suburns05/EGR314SamBurns.github.io/docs/index.md

---
title: Welcome
tags:
- tag1
- tag2
---
<center>
<font size= "6">Sam Burns Datasheet</font><br>
as part of<br>
<font size= "8"> ROV MINI SUB</font><br>
for<br>
<font size= "5"> Team 308 </font><br>

**Submission: May, 4, 2026**
</center>

## Introduction

* This is a project formed out of the reqirements listed in EGR 314 Spring 2026. The tast was to make a reaserch/exploratory vessal to help collect data of a given envitement. We decided to underwater, although this prototype does not go underwater the sensors are dirrected to basic underwater data collection. 

### Project Summary

* We are a team designing a underwater reaserch drone. My main conponet was a wireless controller that serves as a way for the user to see the sensor values from the sub but also to navigate the sub. 
* Team link [team report.](https://egr314-s-2026-308.github.io/)

### My Contribution

* This subsystems is the Teams HMI system. 
* This site serves as documentation of the steps taken to reach the final product of this subsystem.
