suburns05/EGR314SamBurns.github.io/docs/11-Version 2.0/Version 2.0.md

---
title: Version 2.0
---

## Future Possible Updates

If I had a 2nd attempt at this with all I know now, I have a list of changes/improvments I would like to try: 

- Adding abuilt in battery system that was designed to intergrate with the PCB.
- Adding futher menu navigation.
- Improving menu navigation to be more user friednly.
- Implementing mini animations to make the UI feel more active. 
- Increasing the pre-programed measages I can send and request.
- I would like to have spent more time on the case, making it feel more polished and look like a final product. 
- In the future I would also pick larger surface mount parts, although small parts look good the larger they are the easier to solder they are.
- Definetly would want to improve the general power management for the whole project. 
- Looking futher into why one of the directions on one of the joysticks was not working and regaining that functionality back would have been nice.
