suburns05/EGR314SamBurns.github.io/docs/Appendix/index.md

---
title: Appendix - Main Page
---

## Appendix Content

* [Component Selection Process](https://embedded-systems-design.github.io/EGR314DataSheetTemplate/Appendix/01-Componet-Selection/Component-Selection-Process/)
* [Microcontroller Selection Process (to Pic)](https://embedded-systems-design.github.io/EGR314DataSheetTemplate/Appendix/02-Microcontroller-Selection/pic-table/)
* [Power Budget](https://embedded-systems-design.github.io/EGR314DataSheetTemplate/Appendix/03-Power-Budget/Power-Budget/)
<!-- * [Example 01 (Need to remove/hide before review!)](https://embedded-systems-design.github.io/EGR314DataSheetTemplate/Appendix/04-Examples-to-Remove/basic-markdown-examples/)
* [Example 02 (Need to remove/hide before review!)](https://embedded-systems-design.github.io/EGR314DataSheetTemplate/Appendix/04-Examples-to-Remove/charts/) -->

3D model for final product [here](base.STL).
