suburns05/EGR314SamBurns.github.io/docs/12-Resources/Resources.md

---
title: Resources
---

## Links/Files of final product

3D model for final product [here](base.STL). 

The software zip folder for this project can be found [*here*](HMI_SUBSYSTEM.zip)

## Final Look 

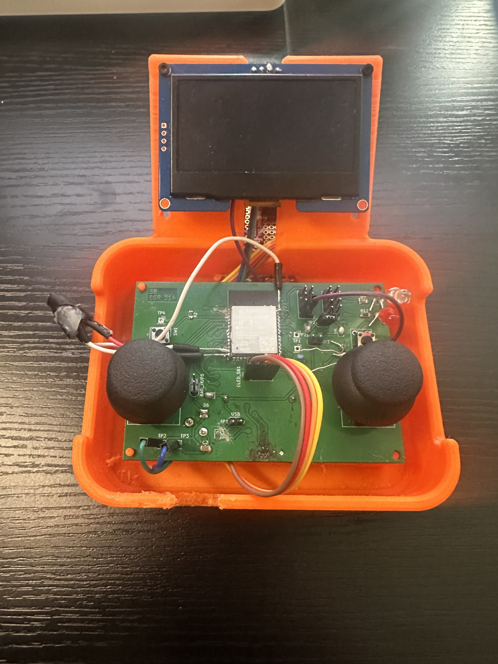
[picture p5: docs/12-Resources/top.jpg]
build

**Figure ##:** Top view of completed project.

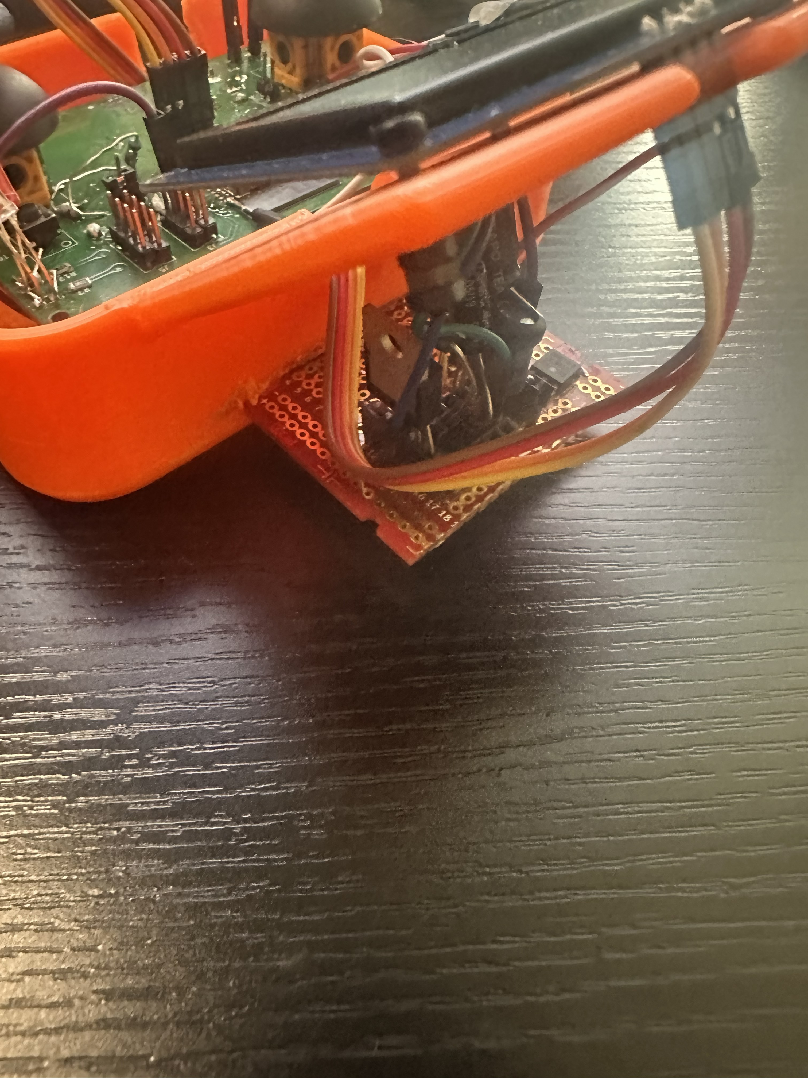
[picture p6: docs/12-Resources/regulator.jpg]
power_supply

**Figure ##:** the external power regulator to help stabalize power.

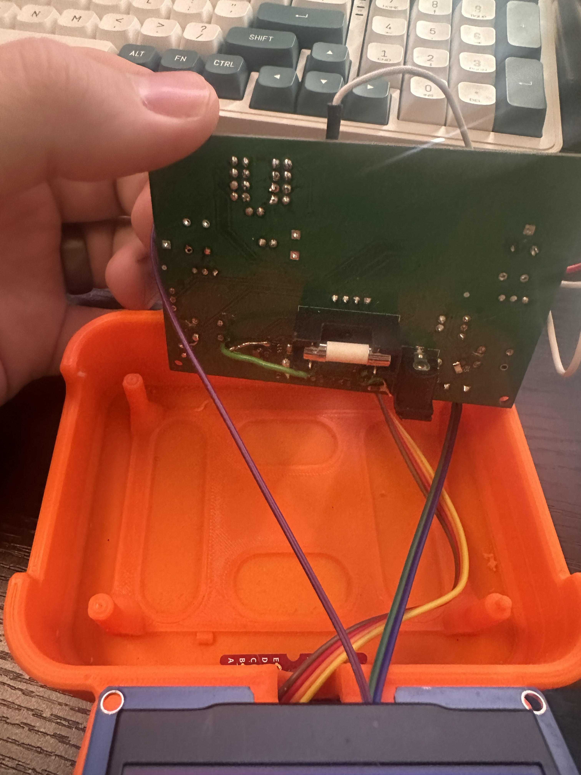
[picture p7: docs/12-Resources/bottom.jpg]
bottom

**Figure ##:** Bottom view of completed project.
