suburns05/EGR314SamBurns.github.io/docs/08-PCB/DFM.pdf

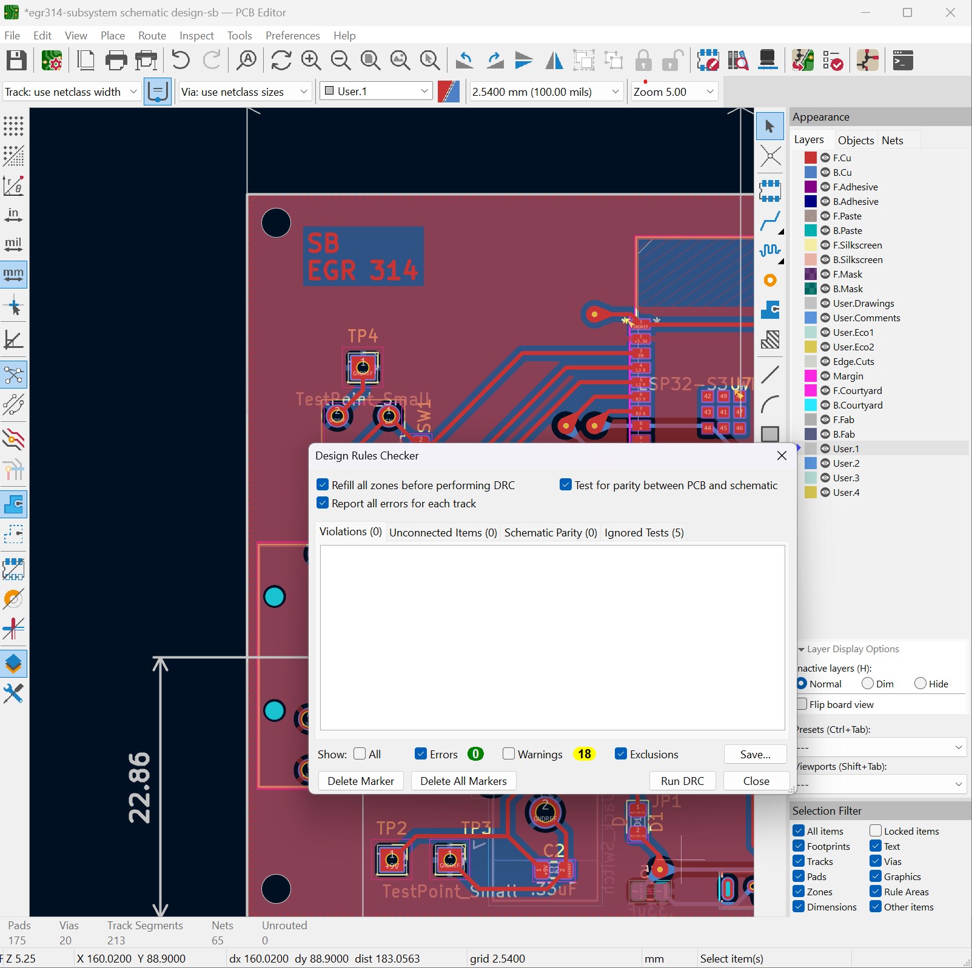
[picture p8: page 1]
