suburns05/EGR314SamBurns.github.io/docs/03-Component-Selection/Component-Selection.md

---
title: Module's Selected Major Components
---

## Module's Selected Major Components

The following are the selected major components necessary for my subsystem of our proejct. This system is the Human Machine Interface, which acts similar to a typical RC remote with additional information and customization that can be done on the fly. 

### Power Management

I will proceed with option 3 due to being the most affordable option I found. I also believe that this option will be the easiest to work with.

### Joystick

I will proceed with #2 due to how simple and inexpensive the product is. It was allowed dispait the combonet being a through hole set up, this part allows for better controll overall. 

### OLED

I choose option 3 due to being largest screen. This will help a lot to show real time data coming back from our submarine.

-----------

### Component selection 

**Joystick**

| **Component** | **Pros** | **Cons** |
| --- | --- | --- |
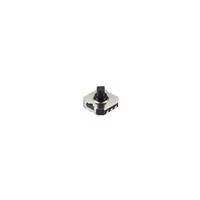
[picture p9: docs/03-Component-Selection/joystick1.png]
| <br> #1 SKRHAAE010 surface mount Joystick<br>$2.98/each<br>[link to product](https://www.digikey.com/en/products/detail/alps-alpine/SKRHAAE010/19529098) | \* Inexpensive <br>\* Low profile <br>\* Meets surface mount constraint of project <br>\* No possible way for to get stick drift | \* Limited output range compared to an analog joystick <br> \* Needs additional parts to be user friendly |
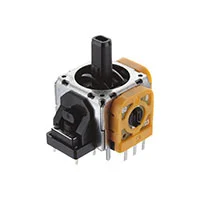
[picture p10: docs/03-Component-Selection/joystick2.png]
| <br> #2 THB001P Through hole mount Joystick<br>$3.04/each<br>[link to product](https://www.digikey.com/en/products/detail/c-k/THB001P/11687191) | \* Typical Joystick configuration <br>\* Highrange of outputs<br>\* Enables persision control | \* Doesn't meet surface mount constraint of project<br>\* Possiblity of stickdrift |
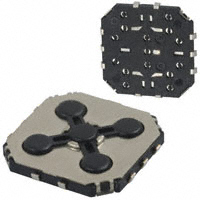
[picture p11: docs/03-Component-Selection/joystick3.png]
| <br> #3 JS1300AQ surface mount D-Pad<br>$2.18/each<br>[link to product](https://www.digikey.com/en/products/detail/e-switch/JS1300AQ/1556576) | \* Larger input area <br>\* Easier to use<br>\* Cheaper compared to other selected options | \*Limited outputs <br>\* Large footprint compared to other selected options | 

**Screen**

| **Component** | **Pros** | **Cons** |
| --- | --- | --- |
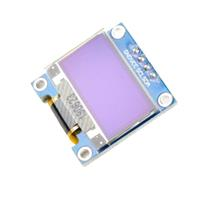
[picture p12: docs/03-Component-Selection/oled1.png]
| <br> #1 26095 Through hole OLED <br>$4.99/each<br>[link to product](https://www.digikey.com/en/products/detail/universal-solder-electronics-ltd/26095/16822116) | \* Familiar with due to Lab <br>\* Low profile <br>\*Popular option with a lot of open source help | \* Small screen <br> \* Doesn't meet Surface mount constraints of project |
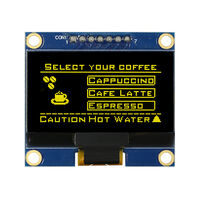
[picture p13: docs/03-Component-Selection/oled2.png]
| <br> #2 WEA012864ALAP3N00E00 Through hole OLED <br>$14.78/each<br>[link to product](https://www.digikey.com/en/products/detail/winstar-display/WEA012864ALAP3N00E00/24883012) | \* Larger screen <br>\* Yellow text | \* Unfamilar pin set up <br> \*Very expensive <br> \* Doesn't meet Surface mount constraints of project |
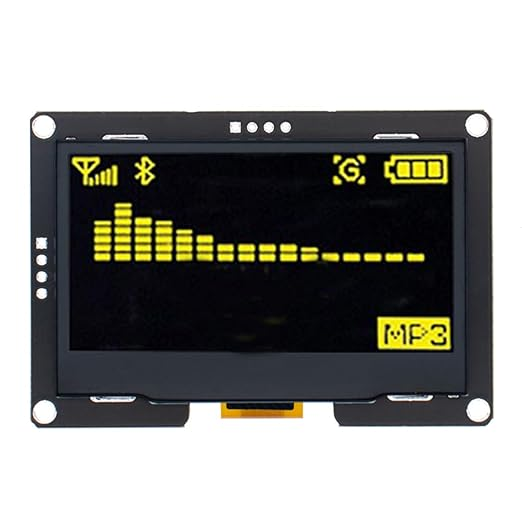
[picture p14: docs/03-Component-Selection/oled3.png]
| <br> #3 B0CFF2TSJ1 Through hole OLED <br>$16.99/each<br>[link to product](https://www.digikey.com/en/products/detail/winstar-display/WEA012864ALAP3N00E00/24883012) | \* Largest screen out of my selection <br>\* Same address as one provided in class, just larger pixels | \* Seems to only be sold on Amazon <br> \*Very expensive <br> \* Doesn't meet Surface mount constraints of project |

**Voltage regulator**

| **Component** | **Pros** | **Cons** |
| --- | --- | --- |
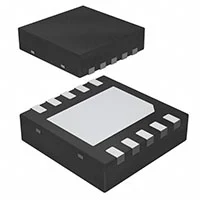
[picture p15: docs/03-Component-Selection/reg1.png]
| <br> #1 LP3996SD-0833/NOPB Dual output Voltage regulator <br>$1.12/each<br>[link to product](https://www.digikey.com/en/products/detail/texas-instruments/LP3996SD-0833-NOPB/1590116) | \* Small foot print <br>\* dual output <br>\*Will short if over powered | \*Limited Input voltage <br> \* Possibly over complicated for project |
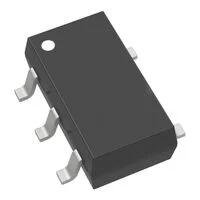
[picture p16: docs/03-Component-Selection/reg2.png]
| <br> #2 MIC5365-3.3YC5-TR Voltage regulator <br>$0.12/each<br>[link to product](https://www.digikey.com/en/products/detail/microchip-technology/MIC5365-3-3YC5-TR/1868094) | \* Simple desing <br>\* Very inexpensive | \* Low input Voltage <br> \* Limited Output current |
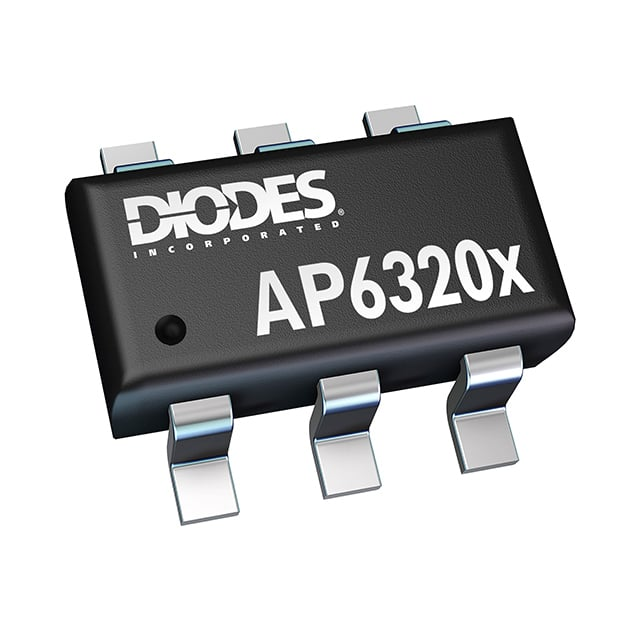
[picture p17: docs/03-Component-Selection/reg3.png]
| <br> #3 AP63203WU-7 Voltage regulator <br>$0.16/each<br>[link to product](https://www.digikey.com/en/products/detail/diodes-incorporated/AP63203WU-7/9858426) | \* Highest input Voltage out of my selection <br>\* Higher output current | \* No over voltage protection built in <br> \*Long manufacturing time  |

<!-- ### Style 2

> Also acceptable, more markdown friendly

**External Clock Module**

1. XC1259TR-ND surface mount crystal

    ![](image1.png)

    * $1/each
    * [link to product](http://www.digikey.com/product-detail/en/ECS-40.3-S-5PX-TR/XC1259TR-ND/827366)

    | Pros                                      | Cons                                                             |
    | ----------------------------------------- | ---------------------------------------------------------------- |
    | Inexpensive                               | Requires external components and support circuitry for interface |
    | Compatible with PSoC                      | Needs special PCB layout.                                        |
    | Meets surface mount constraint of project |

**Rationale:** A clock oscillator is easier ... -->

## Final Notes

I didn't really change any of the major componets. However I either read the datasheet wrong or our regulator was simply not good. Half of our team had breakout board powersupplies due to this simple error that is apparent on all of our boards. For future refference I would pick a requlator that had a larger headroom and also a larger footprint. I think my issue was I some how limited my outgoing current, I got 3.3 v however it would boot cycle if I program it. The OLED and Joysticks were great, 100% recommend using them again.
