suburns05/EGR314SamBurns.github.io/docs/07-BOM/BOM.md

---
title: Module Bill of Materials
tags:
- tag1
- tag2
---

## Overview
Here is a rough over view of my BOM. Very simple break down of my componets that are directly sourced through KiCad. Other then the previously listed major componets there are a lot of ressistor, capacitors and diodes that bring the project to life.

## Bill of Materials 
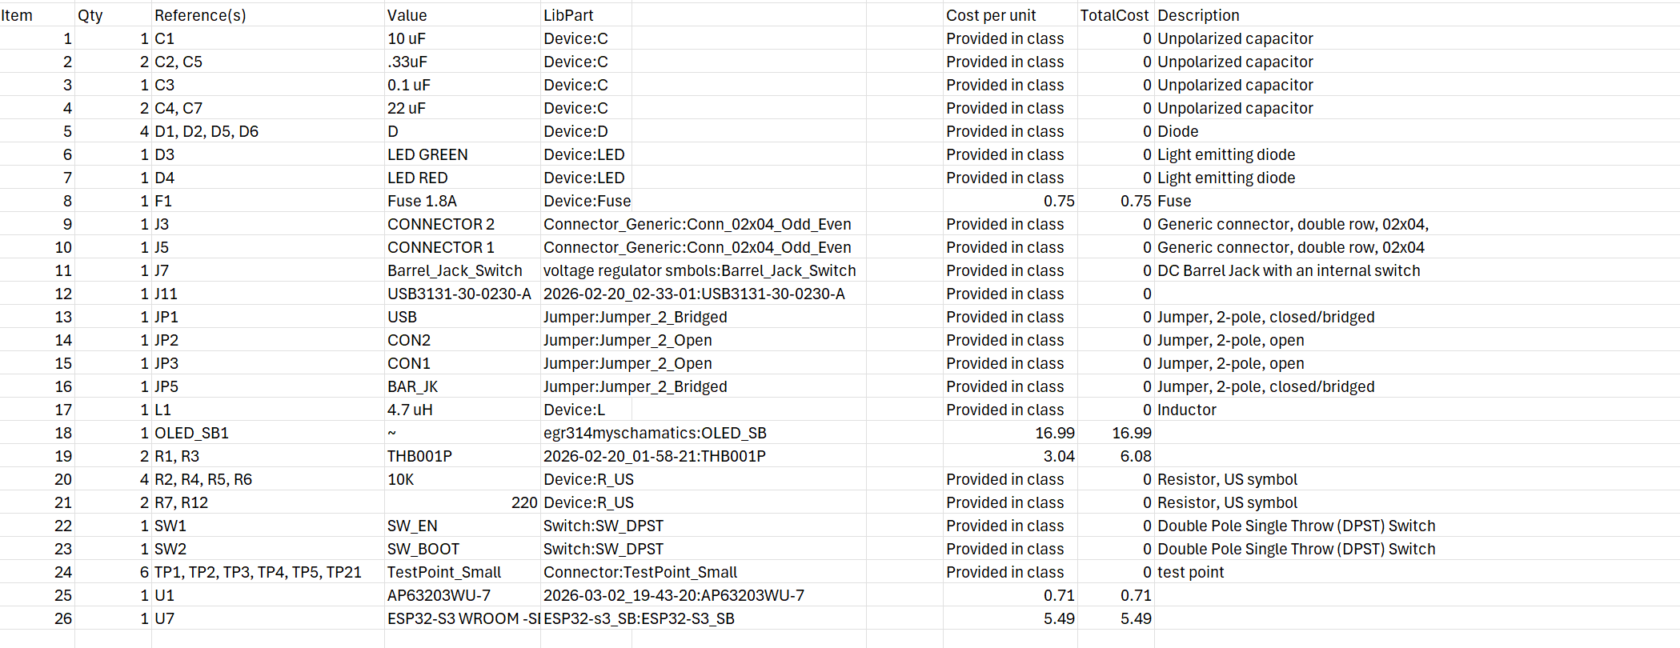
[picture p18: docs/07-BOM/image.png]


As you can see, the text can be difficult to read without opening the image.

## Resouce

The Bill of Material as a PDF download is available [*here*](EGR_314.pdf), and Excel File [here](egr314_BOM.xlsx). See my order request file [fere](EGR-314-Purchase-Request-2026-DIGI-KEY.xlsx) 

## Final Notes

Next time get 2-3x what you would need. If you have the buget, use it. Do not make the same mistake I did. I assumed that the lab/shop would have some of my parts, however if everyone thinks that, it is very likely that those supplies go out quick. I had to make parts that were way to big to my design and make it work. Its good practice to get good at soldering surface mount parts. Howeve I would avoid the headache and get what you need and then some.
