suburns05/EGR314SamBurns.github.io/docs/07-BOM/EGR314_BOM.pdf

Source: C:\Users\umutb\OneDrive - Arizona State University\SPRING 26\egr 314(kicad)\egr314-subsystem schematic design-sb\egr314-subsystem schematic design-sb.kicad_sch
Date: | 2026-03-05T20:36:01-0700
Tool: | Eeschema 9.0.4
Generator: C:\Program Files\KiCad\9.0\bin\scripting\plugins/bom_csv_grouped_by_value.py
Component Count:41

Collated Components:

Item | Qty | Reference(s) | Value | LibPart
1 | 1 C1 | 10 uF | Device:C
2 | 2 C2, C5 | .33uF | Device:C
3 | 1 C3 | 0.1 uF | Device:C
4 | 2 C4, C7 | 22 uF | Device:C
5 | 4 D1, D2, D5, D6 | D | Device:D
6 | 1 D3 | LED GREEN | Device:LED
7 | 1 D4 | LED RED | Device:LED
8 | 1 F1 | Fuse 1.8A | Device:Fuse
9 | 1 J3 | CONNECTOR 2 | Connector_Generic:Conn_02x04_Odd_Even
10 | 1 J5 | CONNECTOR 1 | Connector_Generic:Conn_02x04_Odd_Even
11 | 1 J7 | Barrel_Jack_Switch voltage regulator smbols:Barrel_Jack_Switch
12 | 1 J11 | USB3131-30-0230-A 2026-02-20_02-33-01:USB3131-30-0230-A
13 | 1 JP1 | USB | Jumper:Jumper_2_Bridged
14 | 1 JP2 | CON2 | Jumper:Jumper_2_Open
15 | 1 JP3 | CON1 | Jumper:Jumper_2_Open
16 | 1 JP5 | BAR_JK | Jumper:Jumper_2_Bridged
17 | 1 L1 | 4.7 uH | Device:L
18 | 1 OLED_SB1 | ~ | egr314myschamatics:OLED_SB
19 | 2 R1, R3 | THB001P | 2026-02-20_01-58-21:THB001P
20 | 4 R2, R4, R5, R6 | 10K | Device:R_US
21 | 2 R7, R12 | 220 Device:R_US
22 | 1 SW1 | SW_EN | Switch:SW_DPST
23 | 1 SW2 | SW_BOOT | Switch:SW_DPST
24 | 6 TP1, TP2, TP3, TP4, TP5, TP21 | TestPoint_Small | Connector:TestPoint_Small
25 | 1 U1 | AP63203WU-7 | 2026-03-02_19-43-20:AP63203WU-7
26 | 1 U7 | ESP32-S3 WROOM -SBESP32-s3_SB:ESP32-S3_SB

| Cost per unit | TotalCost
| Provided in class | 0
| Provided in class | 0
| Provided in class | 0
| Provided in class | 0
| Provided in class | 0
| Provided in class | 0
| Provided in class | 0
0.75 0.75
Connector_Generic:Conn_02x04_Odd_Even | Provided in class | 0
Connector_Generic:Conn_02x04_Odd_Even | Provided in class | 0
voltage regulator smbols:Barrel_Jack_Switch | Provided in class | 0
2026-02-20_02-33-01:USB3131-30-0230-A | Provided in class | 0
| Provided in class | 0
| Provided in class | 0
| Provided in class | 0
| Provided in class | 0
| Provided in class | 0
16.99 16.99
3.04 6.08
| Provided in class | 0
| Provided in class | 0
| Provided in class | 0
| Provided in class | 0
| Provided in class | 0
0.71 0.71
5.49 5.49

Description
Unpolarized capacitor
Unpolarized capacitor
Unpolarized capacitor
Unpolarized capacitor
Diode
Light emitting diode
Light emitting diode
Fuse
Generic connector, double row, 02x04, Generic connector, double row, 02x04 DC Barrel Jack with an internal switch

Jumper, 2-pole, closed/bridged Jumper, 2-pole, open
Jumper, 2-pole, open
Jumper, 2-pole, closed/bridged Inductor

Resistor, US symbol
Resistor, US symbol
Double Pole Single Throw (DPST) Switch Double Pole Single Throw (DPST) Switch test point
