suburns05/EGR314SamBurns.github.io/docs/07-BOM/EGR-314-Purchase-Request-2026-DIGI-KEY.xlsx

Sheet: Purchase Request
Course/Capstone/eProject/FURI Purchase Request
Name of Class or Project: EGR 304/314 |  |  |  | Vendor (one vendor per form): Digi-key
Date | Faculty/PI Contact | Student Name & Email | eProject? Capstone Project? Course Project? |  |  | eProject Industry Sponsor (if applicable)
2026-03-05 | Nichols | Sam Burns suburns@asu.edu | Yes / No Yes / No Yes / No |  |  | n/a
A purchasing card is available to check out for local purchases or you may come to Sutton 101 and order your supplies, using this purchasing card.
Qty | Item # or Quote # | Direct Website Link to Product |  | General Description of Item |  | Business Purpose/Benefit for the Purchase | Unit Price | Line Total
6 | 12345ABCDE | www.thisistheplace.com/12345ABCDE (SAMPLE: PLEASE START ON NEXT LINE) |  | safety goggles |  | protect student/instructor eyes while working on project; benefit to the University of reducing number of accidents in the lab | $3.490 | $20.94
4 | THB001P | https://www.digikey.com/en/products/detail/c-k/THB001P/11687191 |  | JOYSTICK |  | allows for control and navigation of controller | $3.04 | $12.16
2 | AP63203WU-7 | https://www.digikey.com/en/products/detail/diodes-incorporated/ap63203wu-7/9858426 |  | 3.3 V 2A converter |  | Converts input Volts to 3.3V | $0.710 | $1.42
3 | ESP32-S3-WROOM-1-N8 | https://www.digikey.com/en/products/detail/espressif-systems/ESP32-S3-WROOM-1-N8/15200089 |  |  |  | Micro chip that runs the prooject | 5.49 | $16.47
1 | 4628 | https://www.digikey.com/en/products/detail/keystone-electronics/4628/2137316 |  | Fuse holder |  | Holds the replaceble fuse | $0.750 | $0.75
 |  |  |  |  |  |  |  | $0.00
 |  |  |  |  |  |  |  | $0.00
 |  |  |  |  |  |  |  | $0.00
 |  |  |  |  |  |  |  | $0.00
 |  |  |  |  |  |  |  | $0.00
 |  |  |  |  |  |  |  | $0.00
 |  |  |  |  |  |  |  | $0.00
 |  |  |  |  |  |  |  | $0.00
 |  |  |  |  |  |  |  | $0.00
 |  |  |  |  |  |  |  | $0.00
 |  |  |  |  |  |  | Sub-Total | $30.80
Chair or PI Approval: |  |  |  |  | Date: |  | Tax
 |  |  |  |  |  |  | Shipping
 |  |  |  |  |  |  | Grand Total | $30.80
Business Purpose/Public Benefit: (Click on yellow line. Next, select an option on the drop-down arrow on the right of the box)
Lab / Classroom / Medical Supplies
Business Purpose: A commodity needed for experimentation, observation or practice in a field of study (such as goggles, aprons, test tubes, flasks, and plates etc).
Public Benefit: Supplies are used in day-to-day lab operations. ASU benefits from this expense as the supplies purchased allow departmental lab employees and students to perform general lab duties, projects, and research activities.
Student: Forward completed form to Instructor/Project Mentor for approval
Mentor/Faculty: Forward form with email indicating your approval to PolyBizz@asu.edu for processing
 | 1. A purchasing card is available to check out for local purchases. 2. You may come to Sutton 101 and place your order online.
SECTION BELOW IS FOR OFFICE USE ONLY
ORDER PLACED BY / DATE: |  |  |  |  |  | B.O. NOTIFIED BY / DATE:
ORDER RECEIVED BY / DATE: |  |  |  |  |  | STUDENT / INSTRUCTOR NOTIFIED BY / DATE:
COST CENTER + PROGRAM/GIFT TO CHARGE:

Sheet: Sheet1
Category |  |  | Reimbursement Justification
Audiovisual Electronic Equipment and Accessories (Non-Capital) | Business Purpose: Non-capital Audiovisual devices, equipment, or accessories purchased to facilitate The Polytechnic School business and operations. | Public Benefit: ASU benefits from this expense as the items purchased allow faculty, staff, and students to conduct video conferencing and/or meetings and discussions with a technological aide to further Polytechnic School business, operations, and maintain partnerships and collaboration with off-campus organizations. | Purchase Made Outside Business Hours | The items or services purchased were made outside of business hours, most often for immediate use outside of business hours. It was necessary for the Requestor to make this purchase, as the need for it was imperative.
Audiovisual R/M Supplies | Business Purpose: Audiovisual commodity items purchased to maintain Audiovisual equipment. | Public Benefit: ASU benefits from this expense as the items purchased allow staff & students to utilize functional Audiovisual equipment in order to further classroom, lab, and research project efforts. | Items/Service Needed While Off Campus | The items or services purchased were needed while the Requestor was doing ASU business off campus and/or in travel status. The purchase was necessary, and standard ASU purchasing methods were unavailable at the time.
Books / Reference Materials | Business Purpose: A set of printed sheets bound together into a volume, printed material, or a digital equivalent that directs a reader or researcher to specific sources of information. | Public Benefit: Books/Reference Materials purchased to assist an instructor with a course. ASU benefits from this expense as the textbook or reference materials purchased allow course instructor to facilitate students in meeting requirements of project and class activities. | Standard ASU Purchasing Methods Not Available | Due to either a system outage/limitation or a personnel issue, the standard ASU Purchasing methods were unavailable at the time that the Requestor needed this purchase to be made.
Credit – Returned Items | Business Purpose: Credit received for returned items. Problem occurred with product, or the product was not received in a timely manner. | Public Benefit: ASU benefits from this credit as the funds can be used to purchase a replacement item, for other project needs, research activities, or operational needs.
Document Printing | Business Purpose: Printing of documents, journals, or other materials for current and future projects. | Public Benefit: This expense ensures that ASU employees and students have proper information when working on research, projects, or operational duties.
Electronic Devices – Computers | Business Purpose: Personal computers and accessories having a life expectancy of less than one year or a unit cost of less than $5,000 purchased to equip an office or lab. | Public Benefit: Personal computers are used to equip faculty, staff, and students with the proper tools to conduct university business and daily activities. ASU benefits from this expense as the computers allow departmental employees and students to perform daily duties.
Electronic Devices – Non Capital | Business Purpose: Non-capital Electronic devices purchased for employees and students to perform testing and complete project requirements. | Public Benefit: ASU benefits from this expense as electronic devices allow faculty, staff, and students to complete projects and to participate in research in the field and then import it into classroom.
Electronic Equipment – Computer Hardware Supplies | Business Purpose: Keyboard, mouse, flash drives, memory, CD and DVD disks, etc purchased to be used by all departmental employees. | Public Benefit: Computer Hardware supplies are used in day-to-day operations. ASU benefits from this expense as the supplies purchased allow departmental employees to perform general job duties, projects, and research.
Electronic Equipment / Accessories | Business Purpose: Non-capital equipment/accessories purchased for employees and students to use in classroom. | Public Benefit: ASU benefits from this expense as the equipment/accessories purchased allow employees to perform daily duties, complete research, and assist students in classroom.
Equipment Repair / Maintenance Materials | Business Purpose: Materials purchased to maintain and run existing equipment in the lab. | Public Benefit: Equipment is used in day-to-day lab operations. ASU benefits from this expense as the supplies purchased allow departmental lab employees and students to perform general lab duties, projects, class activities, and research.
Equipment Repair / Maintenance Service | Business Purpose: Service to repair and/or to maintain existing equipment in the lab in order to allow uninterrupted operations. | Public Benefit: Equipment is used in daily lab operations. ASU benefits from this expense as the equipment repaired and/or maintained allows departmental lab employees and students to perform general lab duties, projects, class activities, and research.
Field Supplies | Business Purpose: A commodity needed to perform field work for research or instructional purposes. | Public Benefit: Field supplies are used in day-to-day field work operations. ASU benefits from this expense as the supplies purchased allow departments to benefit from the research or instructional field work that is produced as a result.
Furniture/Other Equipment (Non-Capital) | Business Purpose: Furniture and other similar non-capital equipment purchased to furnish staff/faculty offices. | Public Benefit: ASU benefits from this expense as the furniture and other similar equipment allows departmental employees to perform daily operations and creates a welcoming and functional environment that is conducive to collaboration and efficiency.
Lab – Chemical Supplies | Business Purpose: Chemicals and similar materials purchased to maintain and/or conduct both daily lab operations as well as current and new research in the lab. | Public Benefit: ASU benefits from this expense as the chemical supplies purchased allow departmental lab employees and students to perform general lab duties, projects, and research activities. Functional labs increase academic and operational success for students, faculty, and staff.
Lab / Classroom / Medical Supplies | Business Purpose: A commodity needed for experimentation, observation or practice in a field of study (such as goggles, aprons, test tubes, flasks, and plates etc). | Public Benefit: Supplies are used in day-to-day lab operations. ASU benefits from this expense as the supplies purchased allow departmental lab employees and students to perform general lab duties, projects, and research activities.
Non-Capital Equipment – Lab / Scientific / Engineering | Business Purpose: Equipment and accessories having a life expectancy of less than one year or a unit cost of less than $5,000 purchased to equip an ASU operational/research laboratory. | Public Benefit: Lab equipment is used to equip departmental labs for employee and student use. ASU benefits from this expense as the equipment purchased allows departmental lab employees and students to perform daily duties that require lab use and/on specific equipment.
Office Operations – Service Requests | Business Purpose: Services to replace, repair, deconstruct, remove, install, and/or otherwise maintain equipment, furniture, walls, space, and/or anything else in the office that can be serviced. | Public Benefit: Office equipment, furniture, walls, and space (etc...) are used in daily office operations. ASU benefits from this expense as the service/maintenance provided allows departmental personnel and students to perform general office duties, projects, activities, and research.
Office Supplies | Business Purpose: Pencils, pens, paper, toner, highlighters and miscellaneous supplies purchased to stock the departmental supply cabinet, used by all departmental employees. | Public Benefit: Supplies are used in day-to-day departmental operations. ASU benefits from this expense as the supplies purchased allow departmental employees to perform general job duties.
Other Services – Miscellaneous | Business Purpose: Payments made for other services not specifically categorized. These expenses benefit daily business, classroom, and research operations. | Public Benefit: This expense benefits ASU in that the services purchased will benefit and/or facilitate classroom, research, and operational needs.
Outgoing Freight | Business Purpose: Outgoing freight to an approved vendor for the shipment of materials, supplies, and/or equipment needed for the completion of a research, student projects, and day-to-day lab and office duties. | Public Benefit: Shipping is necessary in order to deliver materials, supplies, and/or equipment in a timely manner in order to effectively support a project. ASU benefits from this expense as the freight received allows departmental/lab employees and students to perform general lab duties, projects, and class activities.
Parking – ASU Campus Permits | Business Purpose: Green or Red Parking Passes to be used by ASU employees or invited speakers/guests to attend meetings, classes, and functions at the various ASU Campuses. | Public Benefit: ASU benefits from this expense as parking passes ease the burden of parking on campus and assure timely arrival to scheduled meetings and functions. The benefit that ASU Campus Parking Passes provide encourages more frequent meeting and collaboration.
Printing Services | Business Purpose: Printing of any other miscellaneous materials for projects, departmental needs, or Polytechnic School needs. | Public Benefit: This expense ensures that ASU employees and students have proper information when working on research, projects, or operational duties.
Project Supplies | Business Purpose: Materials and supplies purchased to complete a designated project by students and/or departmental employees. | Public Benefit: ASU benefits from this expense as the supplies purchased allow departmental lab employees and students to meet the requirements of their designated project and class activities. The successful completion of project and class activities furthers ASU’s agenda as an exceptional academic institution.
Repair and Maintenance Materials and Supplies | Business Purpose: Commodity items purchased to restore and/or maintain grounds, infrastructure, and utility systems, buildings, or equipment. | Public Benefit: Repair and Maintenance materials and supplies benefit ASU as the materials purchased allow departmental employees to perform daily duties and maintain University property and equipment.
Software and Computing Supplies | Business Purpose: Non-capital equipment or software purchased to equip faculty and staff offices for departmental use. This expense allows for efficient daily lab, business, customer service, and research operations. | Public Benefit: ASU benefits from this expense as the supplies and software purchased allow departmental employees to perform daily general duties, prepare for class instruction and class projects, and complete office duties and projects.
Subscriptions | Business Purpose: Subscriptions allow students, faculty, and staff access to the various services that benefit student and staff success, and that are necessary to meet the needs of projects and research. | Public Benefit: Subscriptions are used in day-to-day operations. ASU benefits from this expense as access to the various subscription services allow students, faculty, and staff to successfully complete projects, research, and class activities.
USPS Charges | Business Purpose: Expenses to send out by priority mail that need to be received very quickly in order to maintain continuity of ASU business. | Public Benefit: This expense will benefit ASU through increased exposure, timely responses, and will allow for new opportunities for The Polytechnic School.
Vehicle R/M Supplies and Services | Business Purpose: Services performed or commodity items purchased to equip, restore, and/or maintain ASU owned vehicles that serve The Polytechnic School and ASU purposes. | Public Benefit: ASU benefits from this expense as R/M services and supplies/materials purchased allow departmental employees to maintain these vehicles and thus perform daily duties that require vehicle use.
