suburns05/EGR314SamBurns.github.io/docs/12-Resources/base.STL

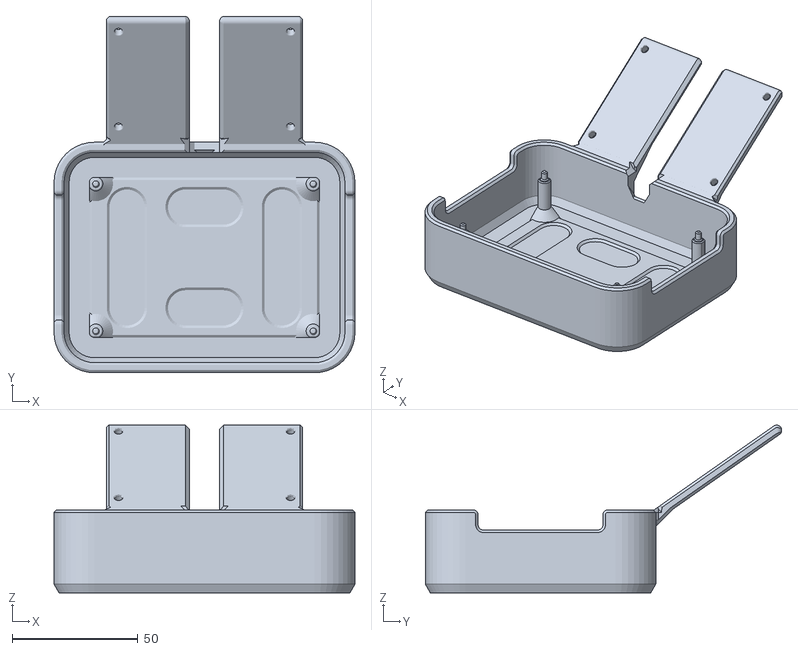
[picture p19: CAD file, 2026-05-04]
docs/12-Resources/base.STL
119.5 x 141.5 x 66.6
