suburns05/EGR314SamBurns.github.io/docs/06-Schematic/schematicSB.pdf

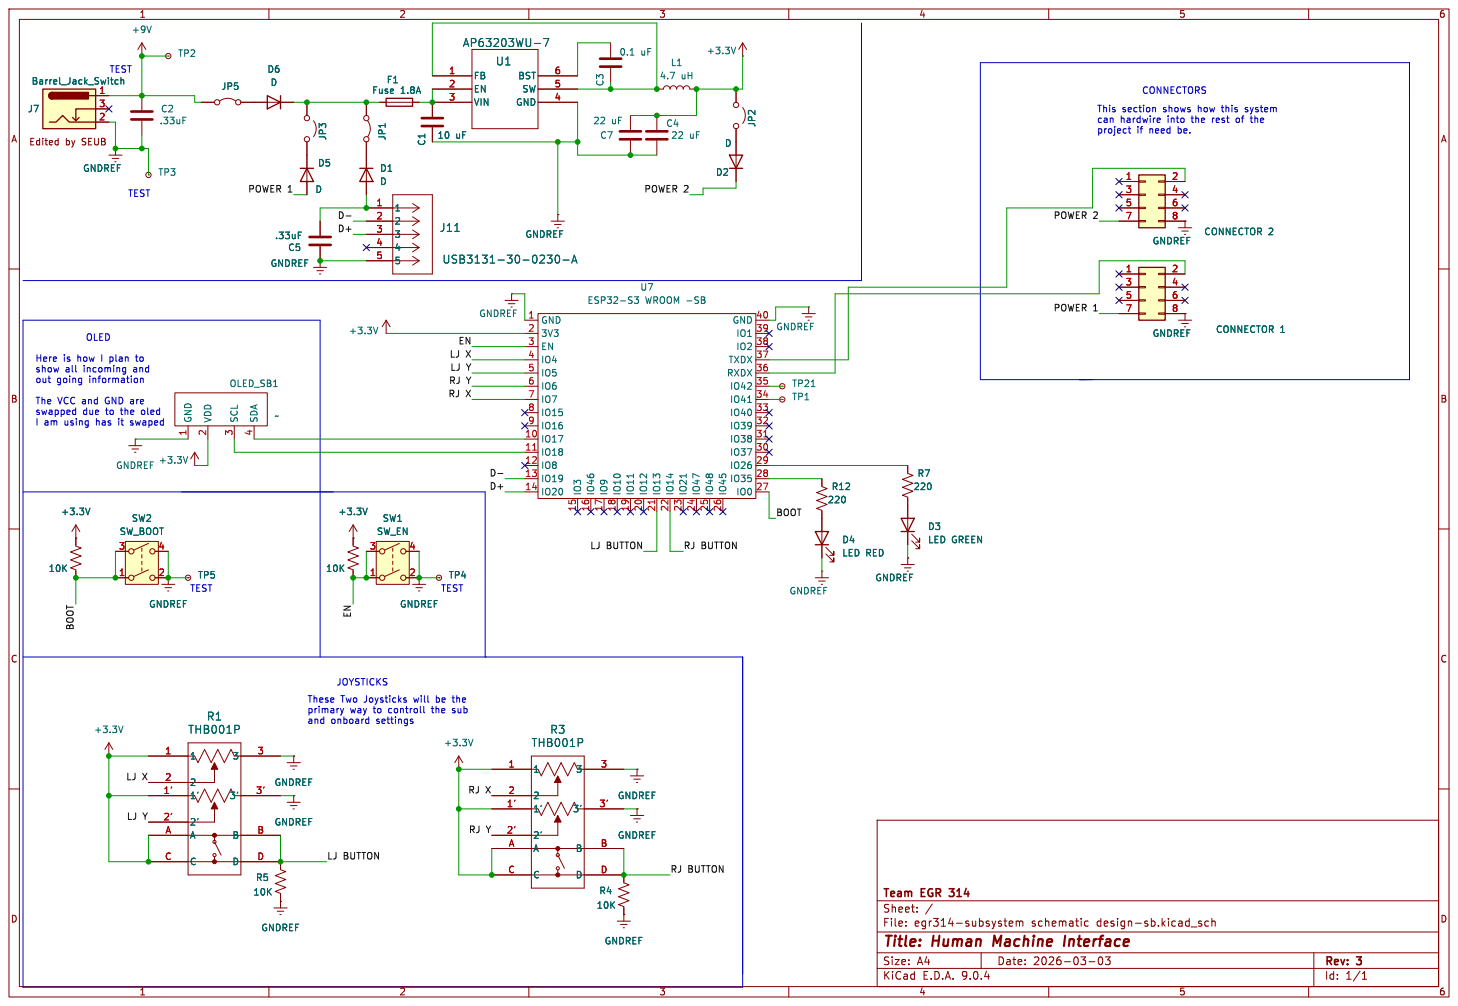
[picture p20: page 1]

This section shows how this system
can hardwire into the rest of the

project if need be. Here is how I plan to
Edited by SEUB

out going information The VCC and GND are
swapped due to the oled

and onboard settings TEST

Id: 1/1 Title: Human Machine Interface
