suburns05/EGR314SamBurns.github.io/docs/02-Block-Diagram/diagram3.pdf

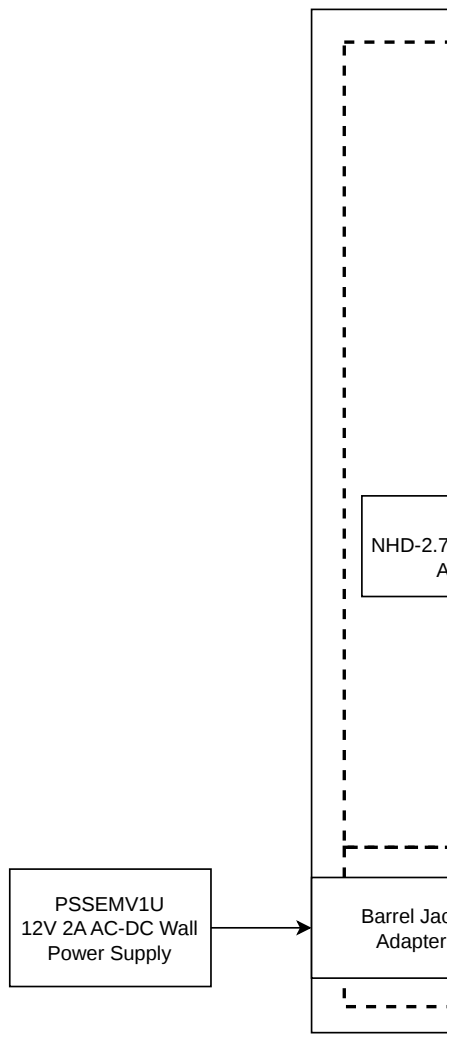
[picture p21: page 1]
Barrel Jac Adapter; NHD-2.7 A

PSSEMV1U
12V 2A AC-DC Wall
Power Supply

## DEVICE CONTROLER BOARD

## Block Diagram -- Sam Burns

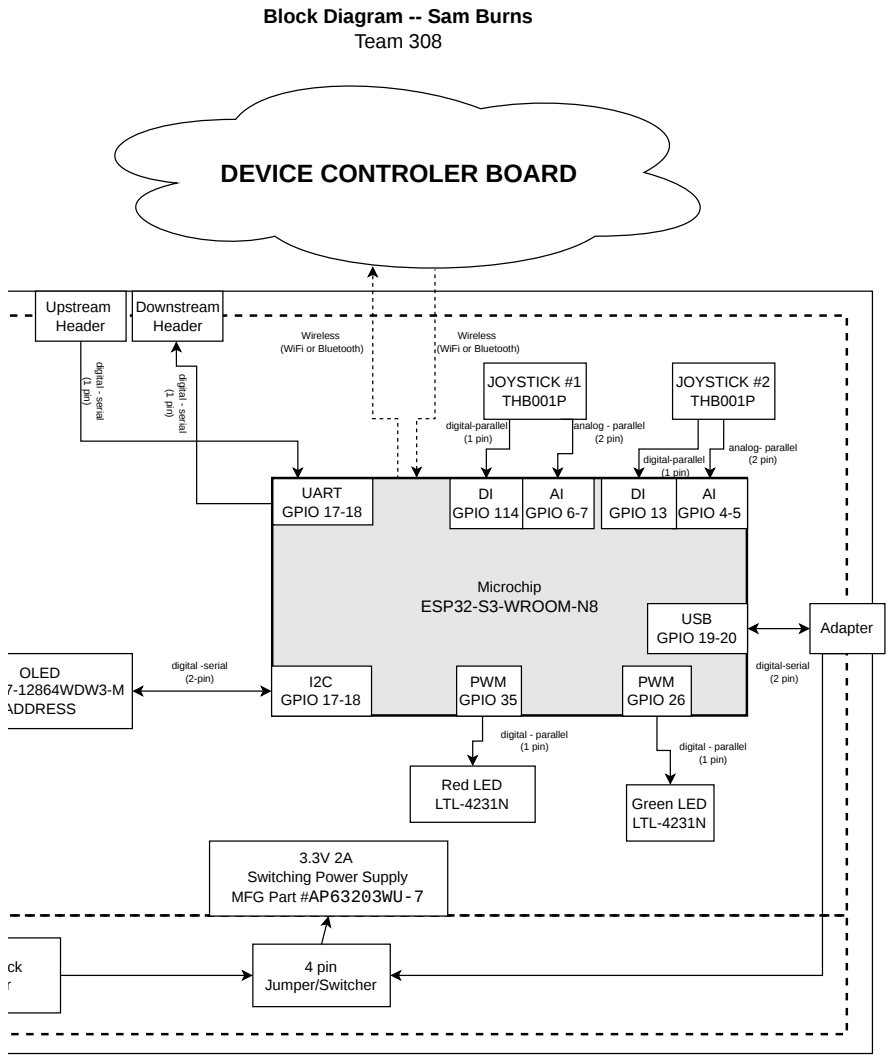
[picture p22: page 2]
digital -serial (2-pin); Team 308; Microchip ESP32-S3-WROOM-N8; I2C GPIO 17-18; PWM GPIO 35; USB GPIO 19-20; Red LED LTL-4231N; OLED 7-12864WDW3-M ADDRESS; UART GPIO 17-18; Upstream Header; Downstream Header; digital - serial; (1 pin); 4 pin Jumper/Switcher; Adapter; Green LED LTL-4231N; PWM GPIO 26; AI GPIO 4-5; AI GPIO 6-7; digital - parallel (1 pin); analog - parallel (2 pin); JOYSTICK #1 THB001P; JOYSTICK #2 THB001P; Wireless (WiFi or Bluetooth); analog- parallel (2 pin); DI GPIO 13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

Wireless
(WiFi or Bluetooth)

Switching Power Supply
MFG Part #AP63203WU-7
