suburns05/EGR314SamBurns.github.io/docs/08-PCB/color.pdf

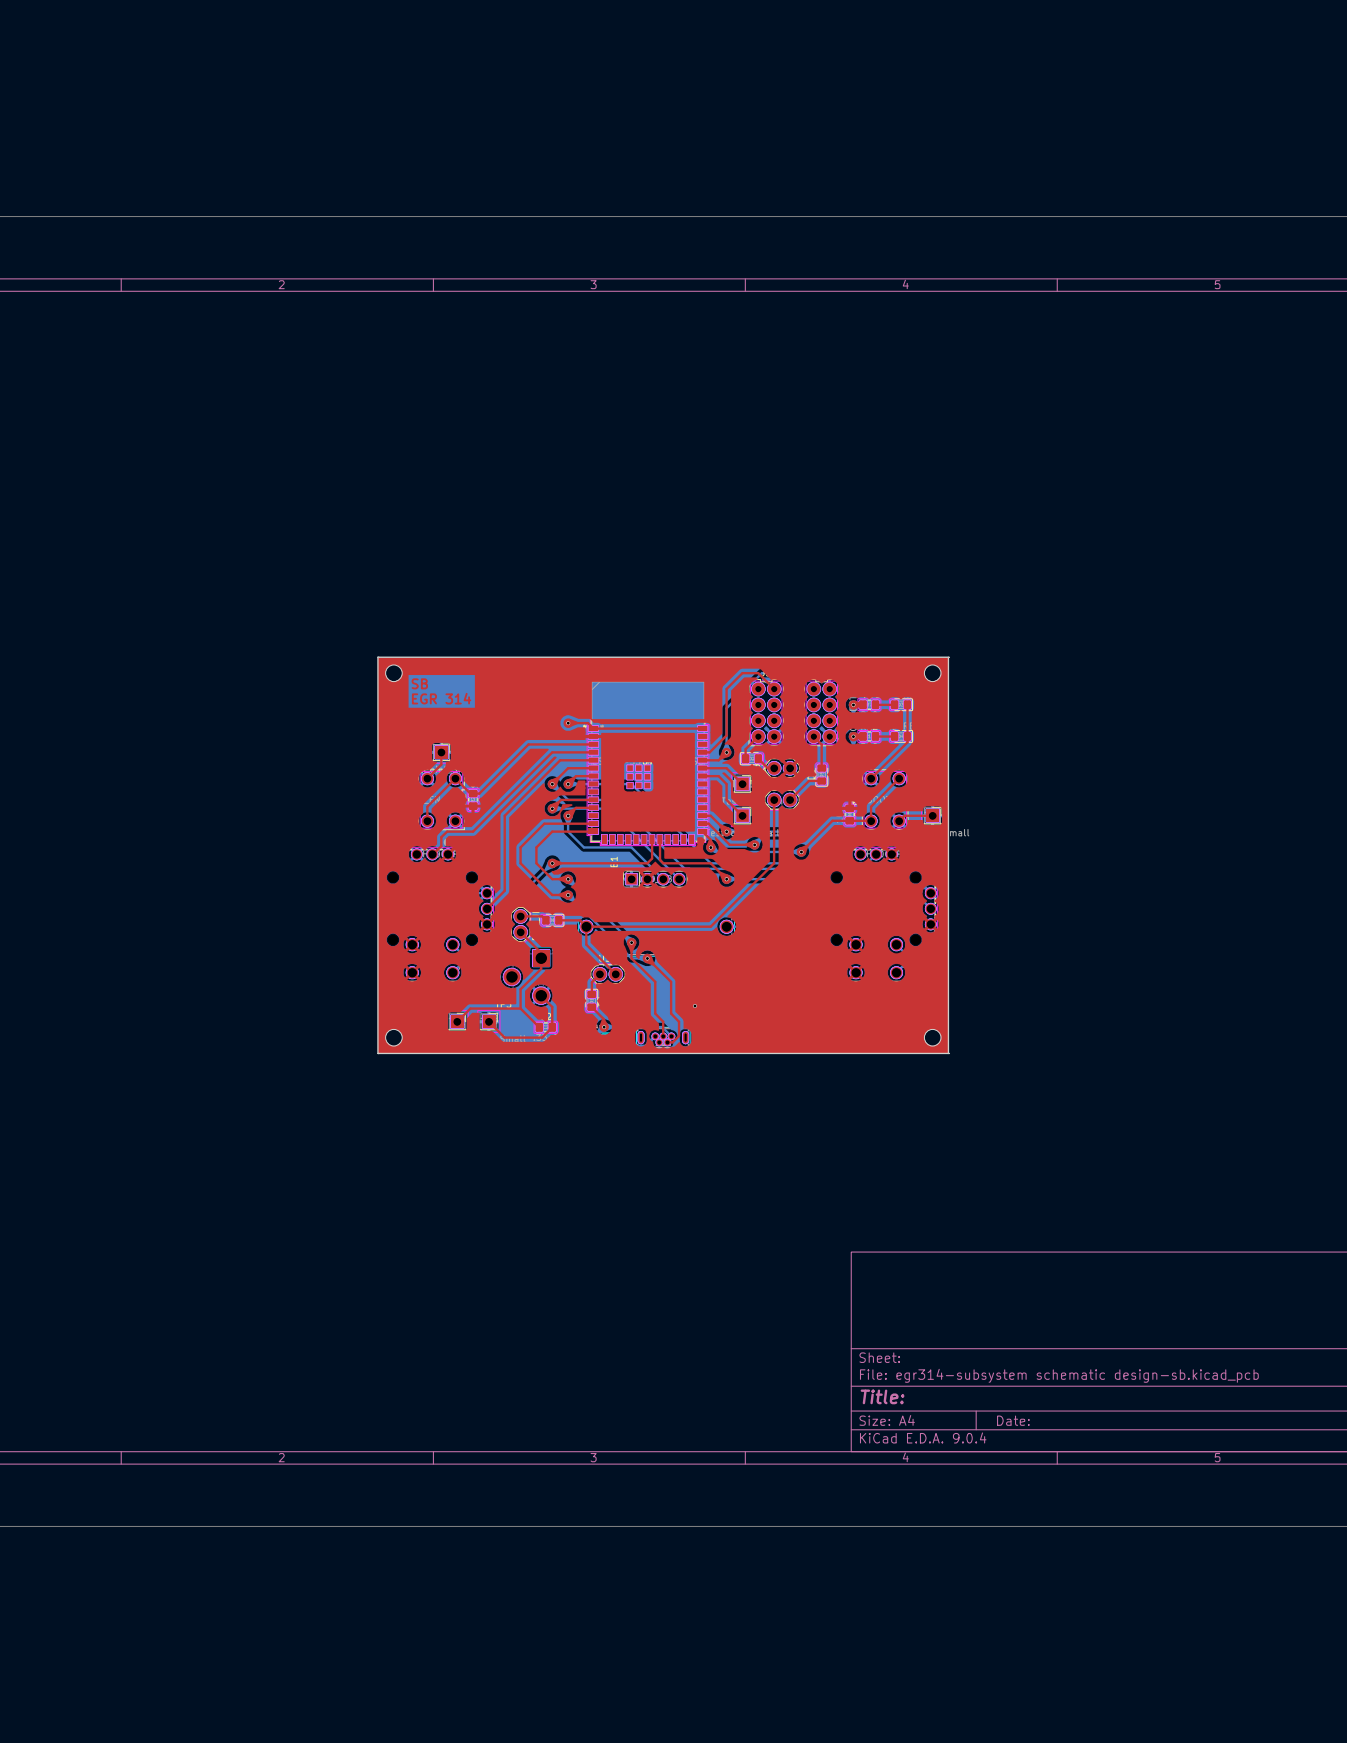
[picture p23: page 1]
