suburns05/EGR314SamBurns.github.io/(commit log)

2026-02-05 updated landing page
2026-02-12 power management complete
2026-02-12 started updating the esp32 page
2026-02-21 Updated page, added schamatic and adding power budger page
2026-02-21 enabled the powerbudget template still needs work
2026-02-25 completed power budget v1
    [PowerBudgetSamBurns.xlsx]
2026-02-25 updated schamatic to current set up
2026-03-06 updated schematic and added PCB
2026-03-06 added the bill of materials page
    [egr314_BOM.xlsx]
2026-03-06 added purchase request to webstie
    [EGR-314-Purchase-Request-2026-DIGI-KEY.xlsx]
2026-03-07 updated Power budgret and diagram
    [PowerBudgetSamBurns.xlsx]
2026-03-07 updated bom
2026-05-04 final major update with all final notes
    [base.STL]
2026-05-05 resources page
    [base.STL]
